Essenter24/STM32-Weather-Station/Hardware/Weather Station - KiCad.pdf

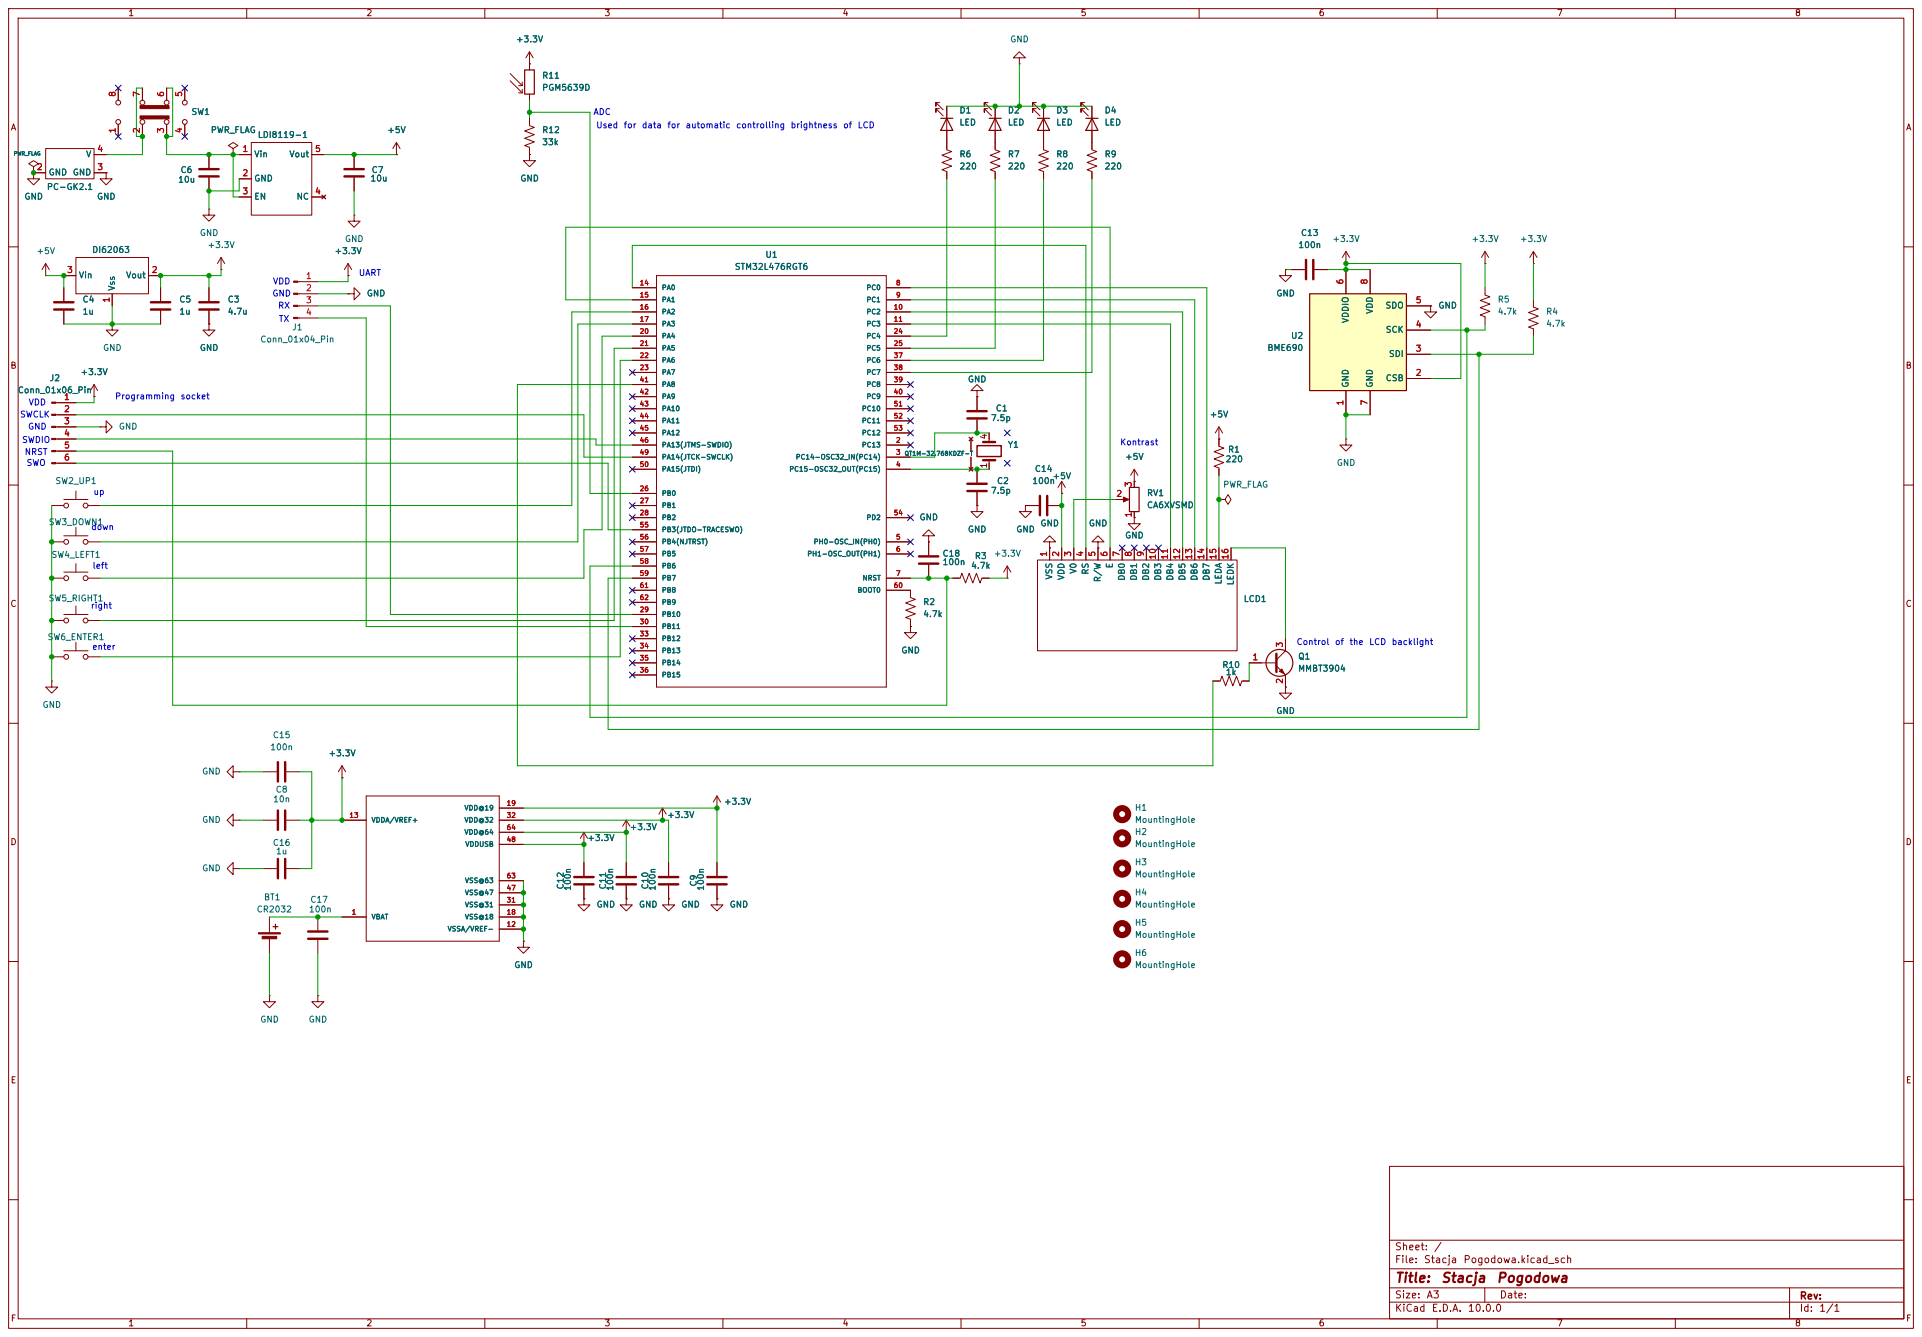
[picture p1: page 1]

Control of the LCD backlight SWDIO

Size: A3 | Rev: | F Date:
KiCad E.D.A. 10.0.0 | Id: 1/1
