Essenter24/STM32-Weather-Station/Hardware/Weather Station - KiCad.kicad_pcb

## KiCad design Hardware/Weather Station - KiCad.kicad_pcb (2026-10-21)

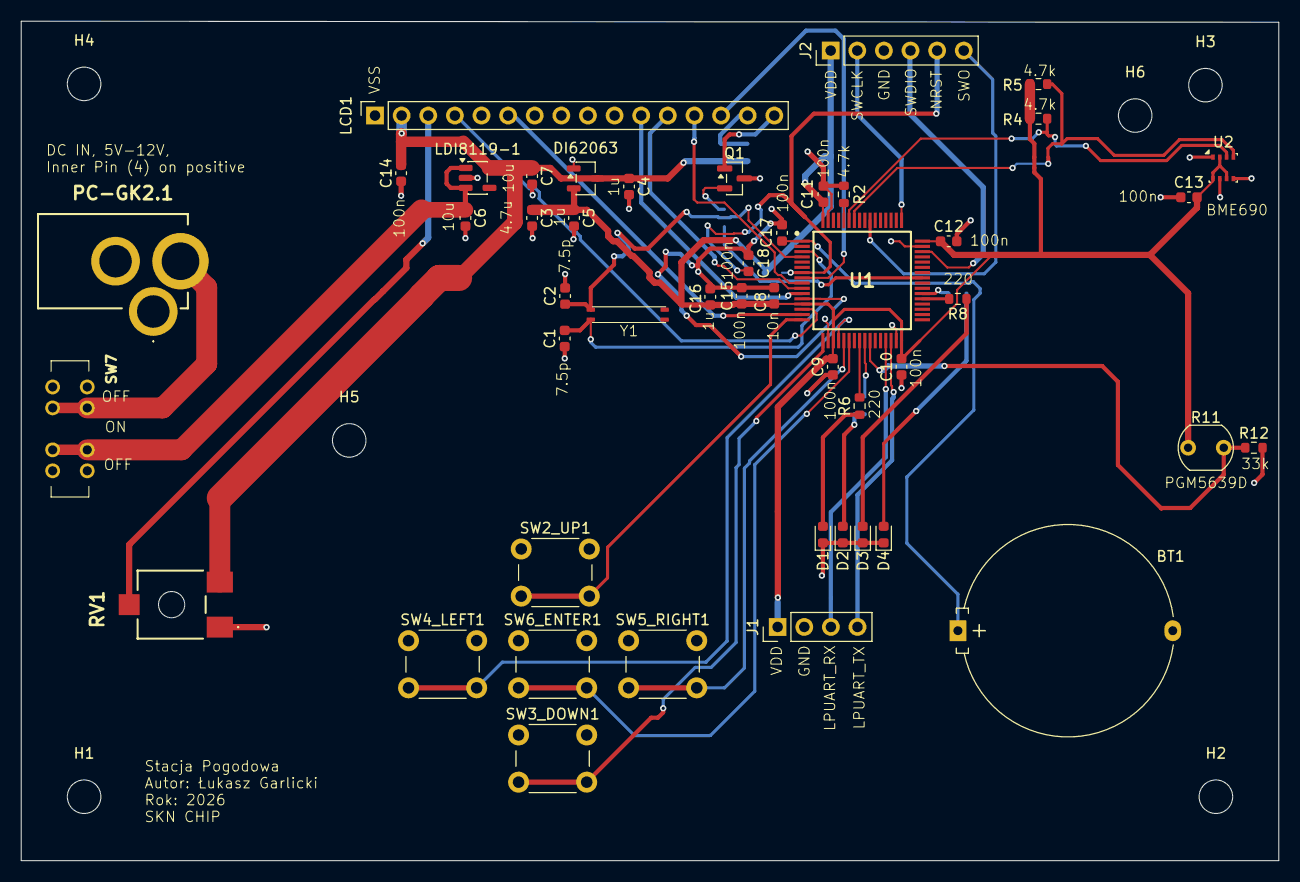
[picture p2: board Weather Station - KiCad.kicad_pcb from above]

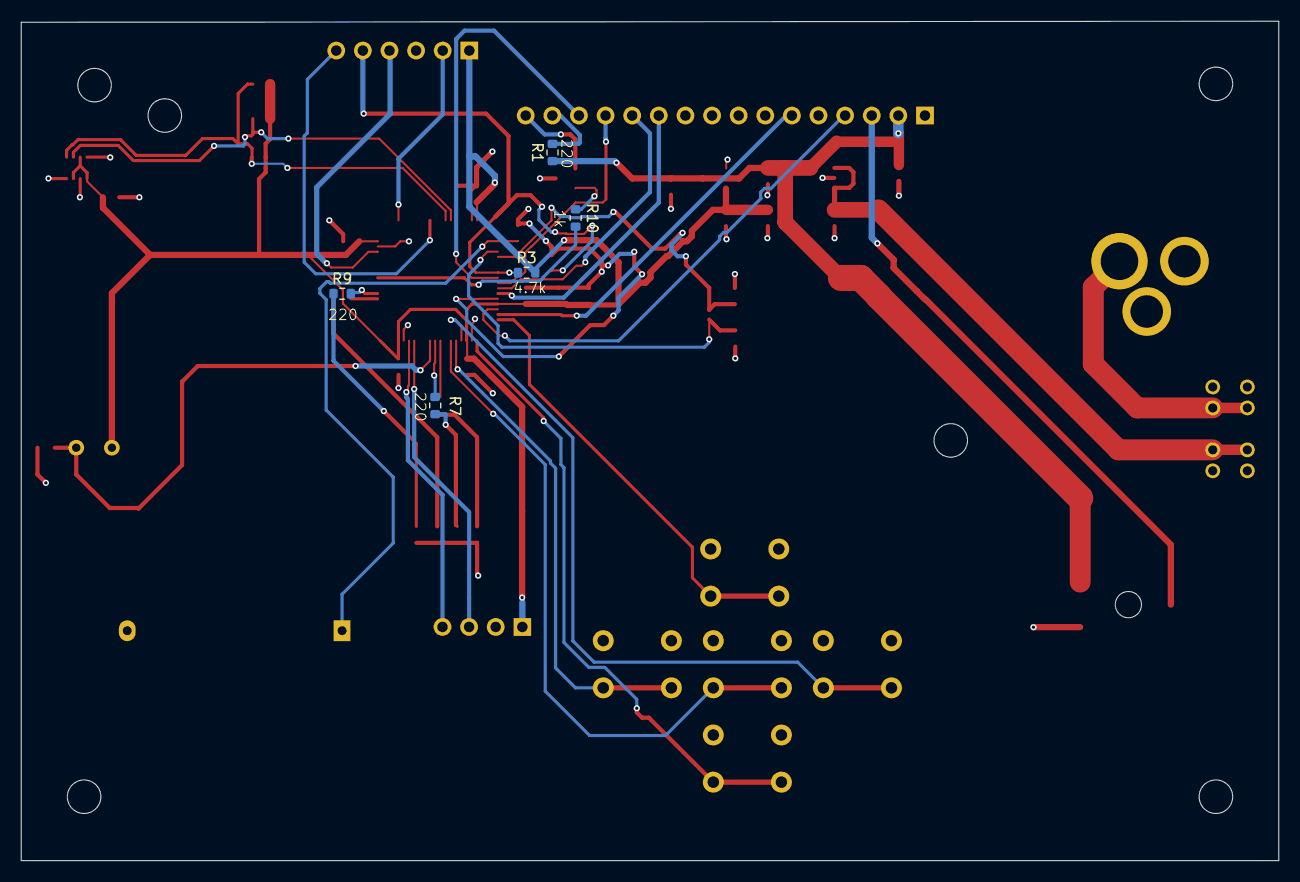
[picture p3: board Weather Station - KiCad.kicad_pcb from below]

Board: 4 copper layers, 120.0 x 80.1 mm, 58 parts (5 on the bottom side), 42 nets.

Parts:
BT1: CR2032; Battery_Panasonic_CR2032-HFN_Horizontal_CircularHoles
C1, C2: 7.5p; C_0603_1608Metric
C3: 4.7u; C_0603_1608Metric
C4, C5, C16: 1u; C_0603_1608Metric
C6, C7: 10u; C_0603_1608Metric
C8: 10n; C_0603_1608Metric
C9, C10, C11, C12, C13, C14, C15, C17, C18: 100n; C_0603_1608Metric
D1, D2, D3, D4: LED; LED_0603_1608Metric
DI62063: SOT-23-3
H1, H2, H3, H4, H5, H6: MountingHole; MountingHole_3.2mm_M3
J1: Conn_01x04_Pin; PinHeader_1x04_P2.54mm_Vertical
J2: Conn_01x06_Pin; PinHeader_1x06_P2.54mm_Vertical
LCD1: PinSocket_1x16_P2.54mm_Vertical
LDI8119-1: SOT-23-5
PC-GK2.1: PCGK21
Q1: MMBT3904; SOT-23
R1, R6, R7, R8, R9: 220; R_0603_1608Metric
R2, R3, R4, R5: 4.7k; R_0603_1608Metric
R10: 1k; R_0603_1608Metric
R11: PGM5639D; R_LDR_5.1x4.3mm_P3.4mm_Vertical
R12: 33k; R_0603_1608Metric
RV1: CA6XVSMD; CA6XVSMD10KA2525
SW2_UP1, SW3_DOWN1, SW4_LEFT1, SW5_RIGHT1, SW6_ENTER1: SW_Push; SW_PUSH_6mm_H5mm
SW7: SW_Slide_DPDT; MSS2346
U1: STM32L476RGT6
U2: BME690; Bosch_LGA-8_2.5x2.5mm_P0.65mm_ClockwisePinNumbering
Y1: QT1M-32.768KDZF-T; QT1M

Connections:
+3.3V: C3.1, C5.1, C8.2, C9.2, C10.2, C11.2, C12.1, C13.2, C15.2, C16.2, DI62063.2 (Vout), J1.1, J2.1, R3.2, R4.1, R5.1, R11.1, U1.13 (VDDA/VREF+), U1.19 (VDD@19), U1.32 (VDD@32), U1.48 (VDDUSB), U1.64 (VDD@64), U2.2 (CSB), U2.6 (VDDIO), U2.8 (VDD)
+5V: C4.1, C7.1, C14.2, DI62063.3 (Vin), LCD1.2 (VDD), LDI8119-1.5 (Vout), R1.1, RV1.3
GND: BT1.2 (-), C1.1, C2.2, C3.2, C4.2, C5.2, C6.2, C7.2, C8.1, C9.1, C10.1, C11.1, C12.2, C13.1, C14.1, C15.1, C16.1, C17.1, C18.1, D1.1 (K), D2.1 (K), D3.1 (K), D4.1 (K), DI62063.1 (Vss), J1.2, J2.3, LCD1.1 (VSS), LCD1.5 (R/W), LDI8119-1.2 (GND), PC-GK2.1.2 (GND), PC-GK2.1.3 (GND), Q1.3 (E), R2.2, R12.2, RV1.1, SW2_UP1.1, SW3_DOWN1.1, SW4_LEFT1.1, SW5_RIGHT1.1, SW6_ENTER1.1, U1.12 (VSSA/VREF-), U1.18 (VSS@18), U1.31 (VSS@31), U1.47 (VSS@47), U1.63 (VSS@63), U2.1 (GND), U2.5 (SDO), U2.7 (GND)
unnamed: BT1.1 (+), C17.2, U1.1 (VBAT)
unnamed: D1.2 (A), R6.1
unnamed: D2.2 (A), R7.1
unnamed: D3.2 (A), R8.1
unnamed: D4.2 (A), R9.1
unnamed: J1.3, U1.29 (PB10)
unnamed: J1.4, U1.30 (PB11)
unnamed: J2.2, U1.49 (PA14(JTCK-SWCLK))
unnamed: J2.4, U1.46 (PA13(JTMS-SWDIO))
unnamed: C18.2, J2.5, R3.1, U1.7 (NRST)
unnamed: J2.6, U1.55 (PB3(JTDO-TRACESWO))
unnamed: LCD1.11 (DB4), U1.11 (PC3)
unnamed: LCD1.12 (DB5), U1.10 (PC2)
unnamed: LCD1.13 (DB6), U1.9 (PC1)
unnamed: LCD1.14 (DB7), U1.8 (PC0)
unnamed: LCD1.6 (E), U1.15 (PA1)
unnamed: LCD1.15 (LEDA), R1.2
unnamed: LCD1.16 (LEDK), Q1.1 (C)
unnamed: LCD1.4 (RS), U1.14 (PA0)
unnamed: LCD1.3 (V0), RV1.2
unnamed: C6.1, LDI8119-1.1 (Vin), LDI8119-1.3 (EN), SW7.3 (C), SW7.6 (A)
unnamed: PC-GK2.1.4 (V), SW7.2 (B), SW7.7 (B)
unnamed: Q1.2 (B), R10.2
unnamed: R2.1, U1.60 (BOOT0)
unnamed: SW2_UP1.2, U1.16 (PA2)
unnamed: SW3_DOWN1.2, U1.17 (PA3)
unnamed: SW4_LEFT1.2, U1.20 (PA4)
unnamed: SW5_RIGHT1.2, U1.21 (PA5)
unnamed: SW6_ENTER1.2, U1.22 (PA6)
unnamed: R10.1, U1.41 (PA8)
unnamed: R11.2, R12.1, U1.26 (PB0)
unnamed: R5.2, U1.58 (PB6), U2.4 (SCK)
unnamed: R4.2, U1.59 (PB7), U2.3 (SDI)
unnamed: R6.2, U1.24 (PC4)
unnamed: R7.2, U1.25 (PC5)
unnamed: R8.2, U1.37 (PC6)
unnamed: R9.2, U1.38 (PC7)
unnamed: C1.2, U1.3 (PC14-OSC32_IN(PC14)), Y1.4 (2)
unnamed: C2.1, U1.4 (PC15-OSC32_OUT(PC15)), Y1.1
