Essenter24/STM32-Weather-Station/Core/Src/main.c

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
/* Includes ------------------------------------------------------------------*/
#include "main.h"
#include "adc.h"
#include "dma.h"
#include "i2c.h"
#include "usart.h"
#include "rtc.h"
#include "tim.h"
#include "gpio.h"

/* USER CODE BEGIN Includes */
#include <stdio.h>
#include <string.h>
#include <stdlib.h>
#include "lcd.h"
#include "bme69x.h"
#include "bme69x_defs.h"
#include "bme690_port.h"
#include "circular_buffer.h"
#include "button.h"
#include "ui_control.h"
#include "adc_filter.h"
#include "display_manager.h"
#include "uart_transmit.h"
/* USER CODE END Includes */


void SystemClock_Config(void);
/* USER CODE BEGIN 0 */

void DWT_Init(void){
    CoreDebug->DEMCR |= CoreDebug_DEMCR_TRCENA_Msk;
    DWT->CYCCNT = 0;
    DWT->CTRL |= DWT_CTRL_CYCCNTENA_Msk;
}



void UART_Send_Data(void){

}
/* USER CODE END 0 */

/**
  * @brief  The application entry point.
  * @retval int
  */
int main(void)
{

  /* MCU Configuration--------------------------------------------------------*/

  /* Reset of all peripherals, Initializes the Flash interface and the Systick. */
  HAL_Init();

  /* Configure the system clock */
  SystemClock_Config();

  /* Initialize all configured peripherals */
  MX_GPIO_Init();
  MX_DMA_Init();
  MX_RTC_Init();
  MX_I2C1_Init();
  MX_ADC1_Init();
  MX_TIM1_Init();
  MX_LPUART1_UART_Init();
  MX_TIM3_Init();
  /* USER CODE BEGIN 2 */

  LL_DMA_EnableIT_TC(DMA2, LL_DMA_CHANNEL_6);
  LL_DMA_EnableIT_TE(DMA2, LL_DMA_CHANNEL_6);


  LL_TIM_EnableIT_UPDATE(TIM3);
  LL_TIM_EnableCounter(TIM3);
  LL_TIM_CC_EnableChannel(TIM1, LL_TIM_CHANNEL_CH1);
  LL_TIM_EnableCounter(TIM1);

  DWT_Init();
  LCD_Init();
  LCD_Clear();

  BME690_Init();
  ADC_Init();



  /* USER CODE END 2 */

  /* Infinite loop */
  /* USER CODE BEGIN WHILE */
  while (1)
  {

     Handle_BME690_Data();
     UI_Process_Buttons();
     UART_Transmit();
     UI_UpdateDisplay();
    /* USER CODE END WHILE */

    /* USER CODE BEGIN 3 */
  }
  /* USER CODE END 3 */
}

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
